raj-akhil-1/Exoskeleton/README.md

# Exoskeleton

please refer https://github.com/raj-akhil-1/Exoskeleton/blob/main/researchpapers/Exoskeleton%20Final%20Report.pdf
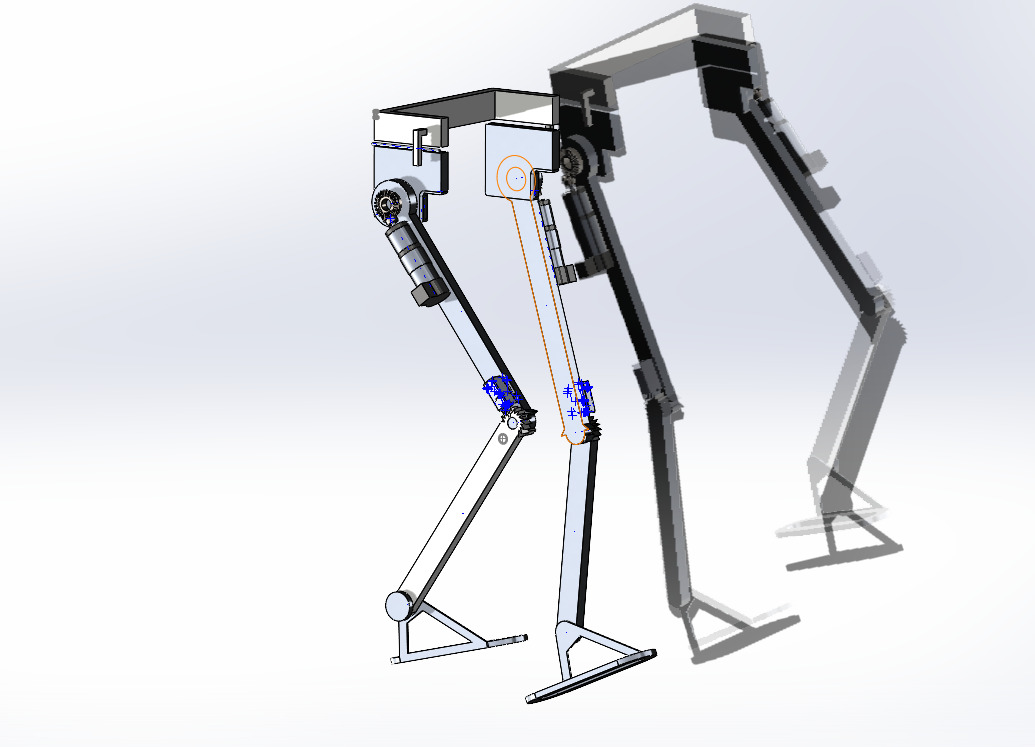
[picture p1: Results/model.png]
