raj-akhil-1/Exoskeleton/analysisresults/Screenshot (6).png

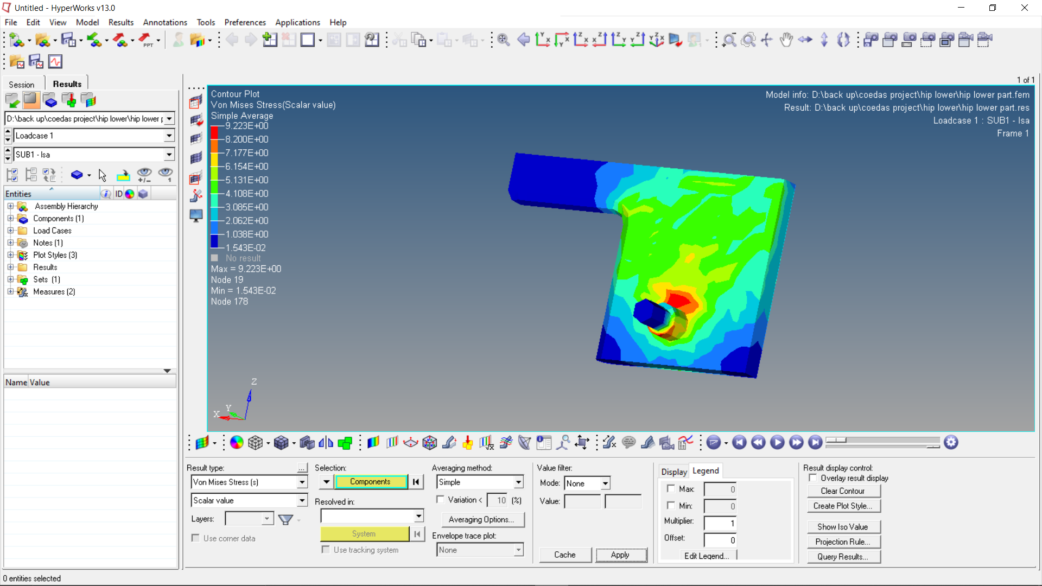
analysisresults/Screenshot (6).png
