raj-akhil-1/Exoskeleton/analysisresults/Screenshot (12).png

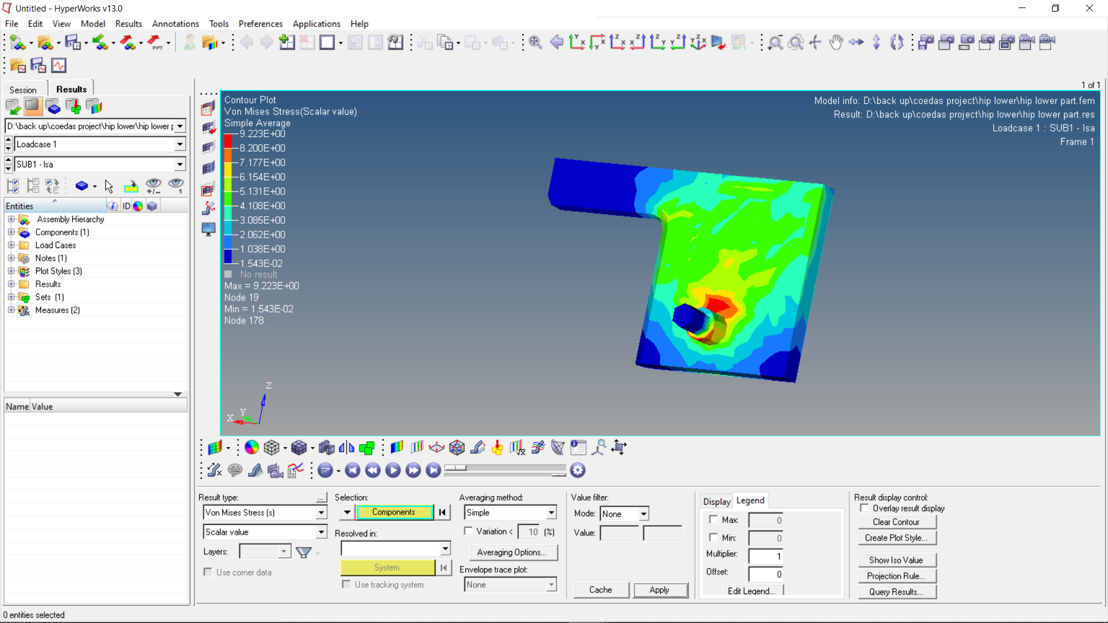
analysisresults/Screenshot (12).png
