raj-akhil-1/Exoskeleton/analysisresults/Screenshot (13).png

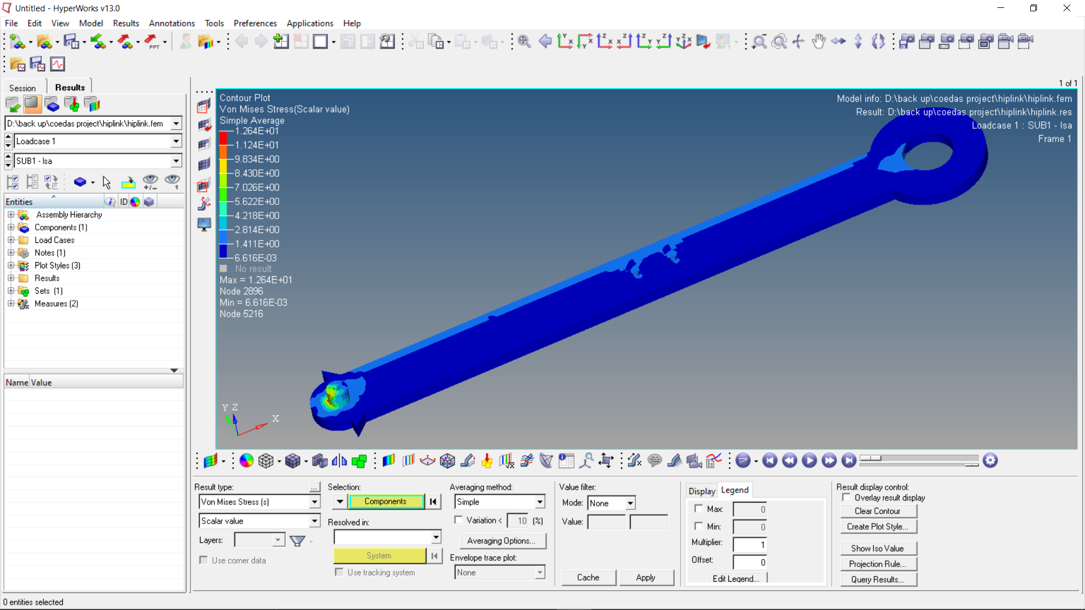
analysisresults/Screenshot (13).png
