raj-akhil-1/Exoskeleton/analysisresults/Screenshot (14).png

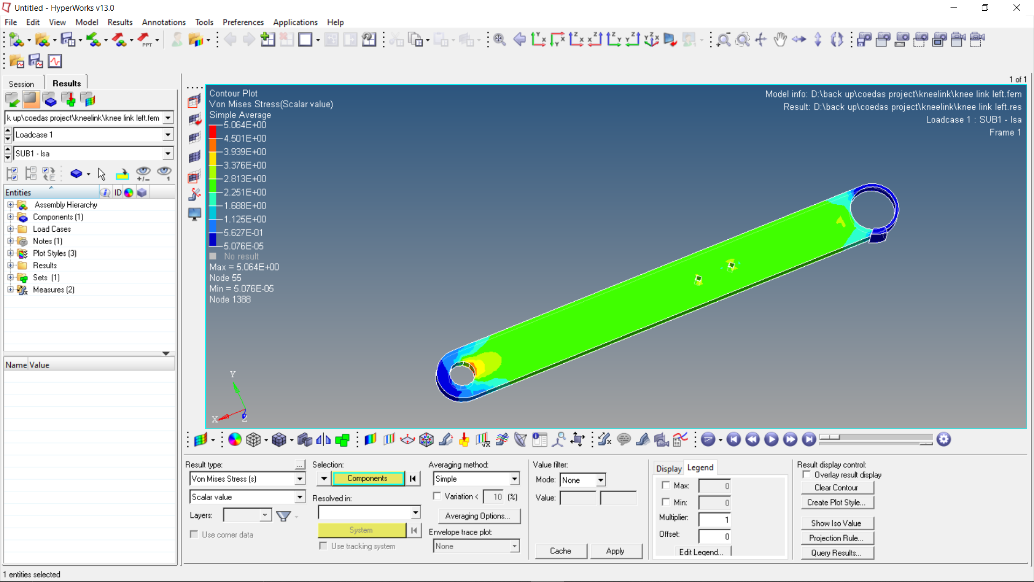
analysisresults/Screenshot (14).png
