raj-akhil-1/Exoskeleton/analysisresults/Screenshot (31).png

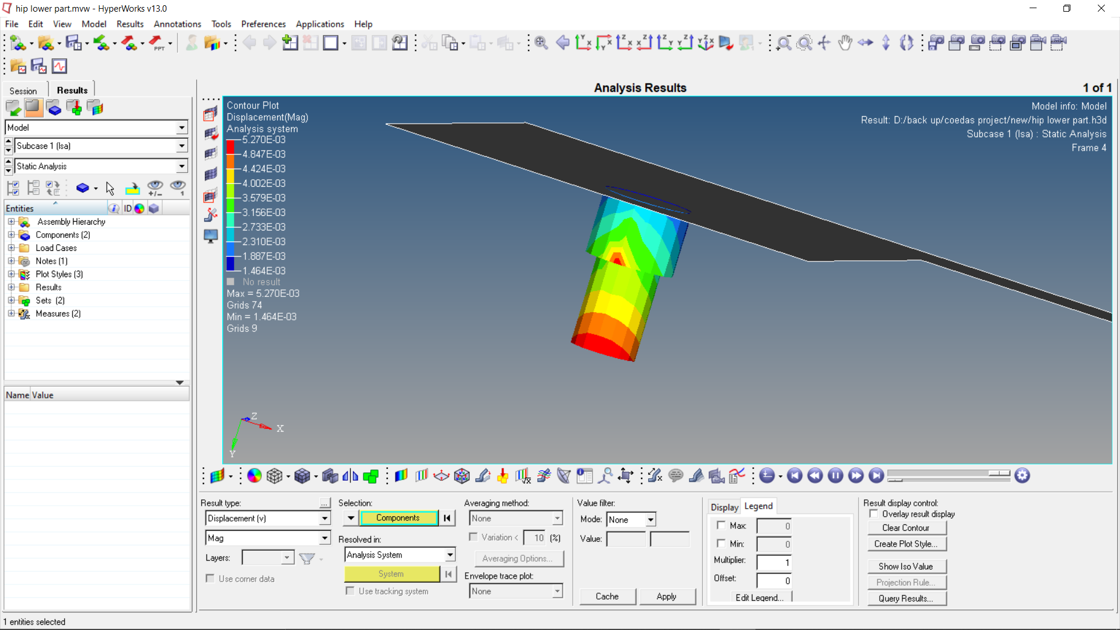
analysisresults/Screenshot (31).png
