raj-akhil-1/Exoskeleton/analysisresults/Screenshot (32).png

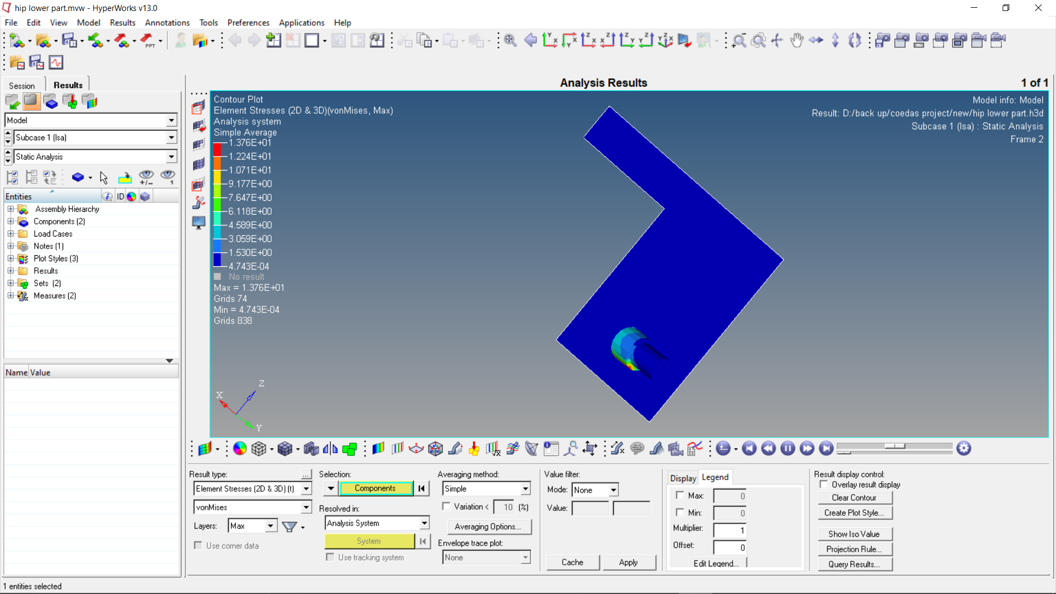
analysisresults/Screenshot (32).png
