raj-akhil-1/Exoskeleton/analysisresults/Screenshot (33).png

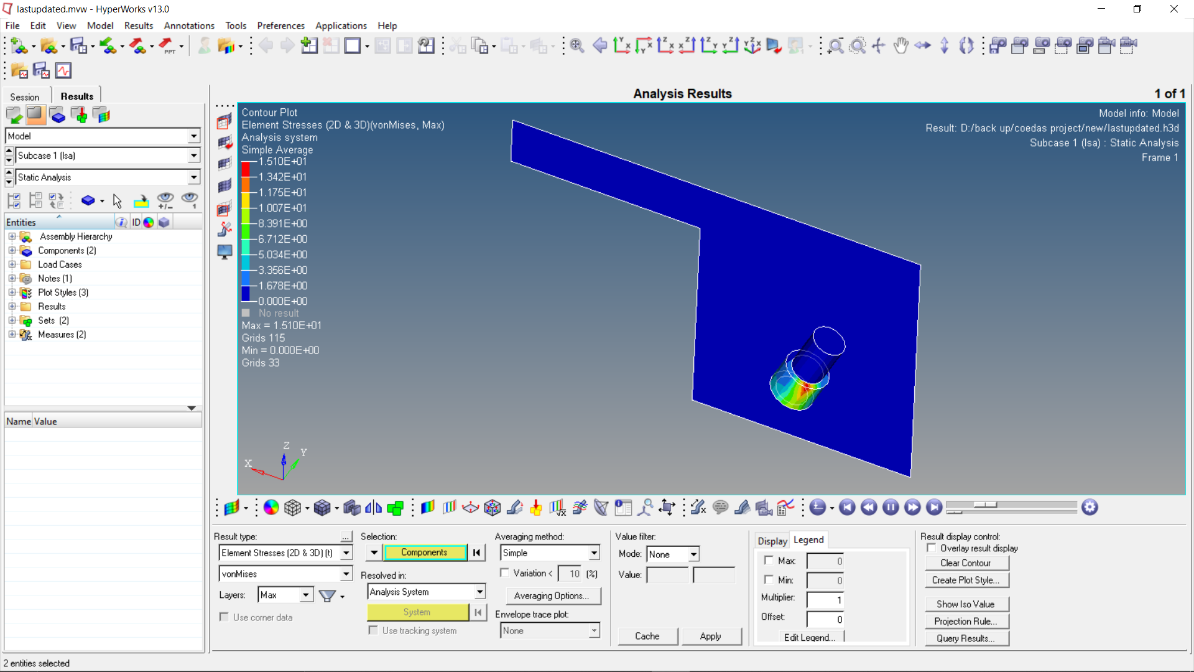
analysisresults/Screenshot (33).png
