raj-akhil-1/Exoskeleton/analysisresults/Screenshot (34).png

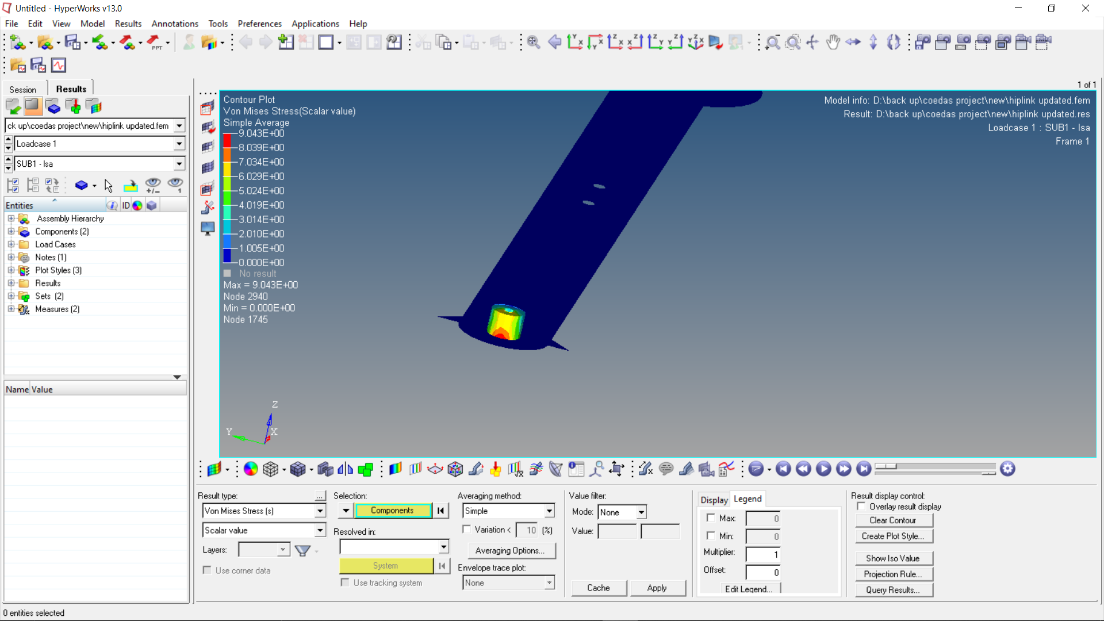
analysisresults/Screenshot (34).png
