raj-akhil-1/Exoskeleton/analysisresults/Screenshot (39).png

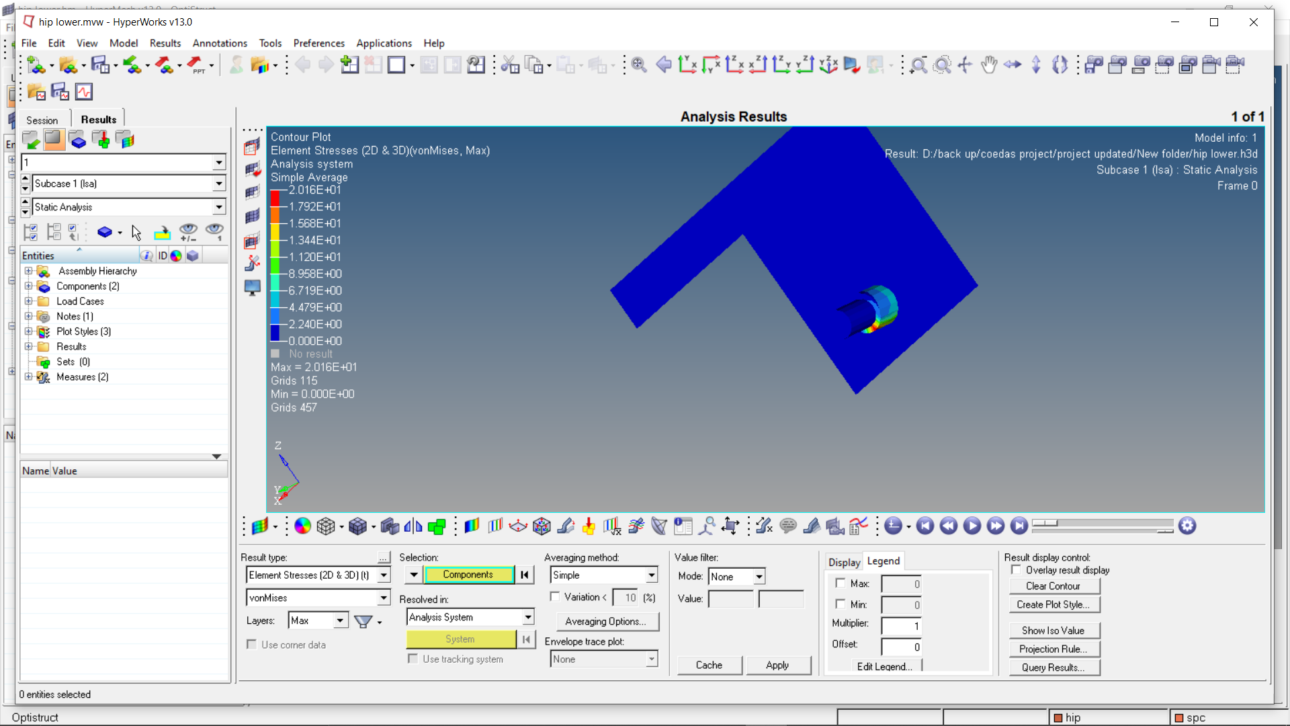
analysisresults/Screenshot (39).png
