raj-akhil-1/Exoskeleton/model/vcgcb.SLDASM

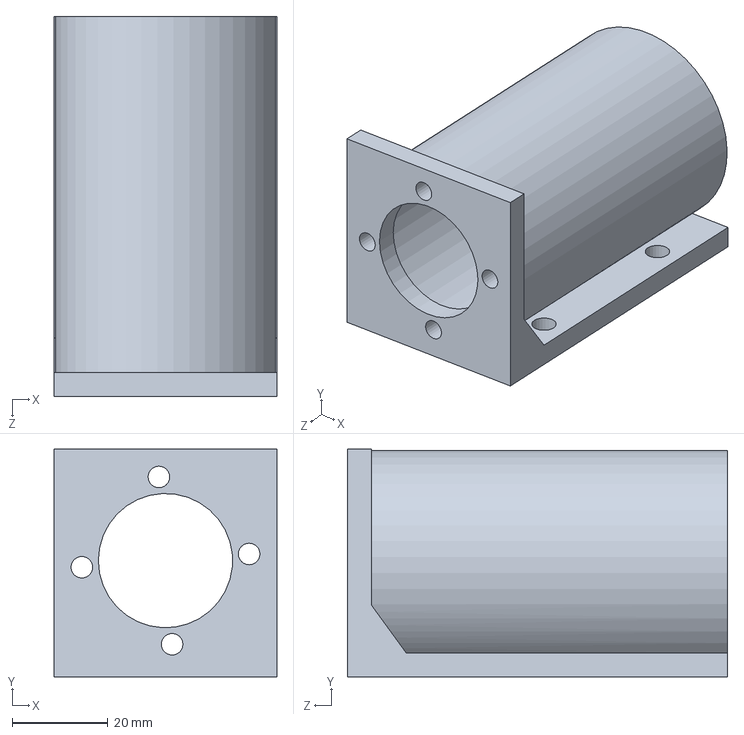
[picture p77: CAD file, 2023-05-04]
model/vcgcb.SLDASM
46.5 x 47.5 x 79.3 mm
