raj-akhil-1/Exoskeleton/model/knee lock.SLDASM

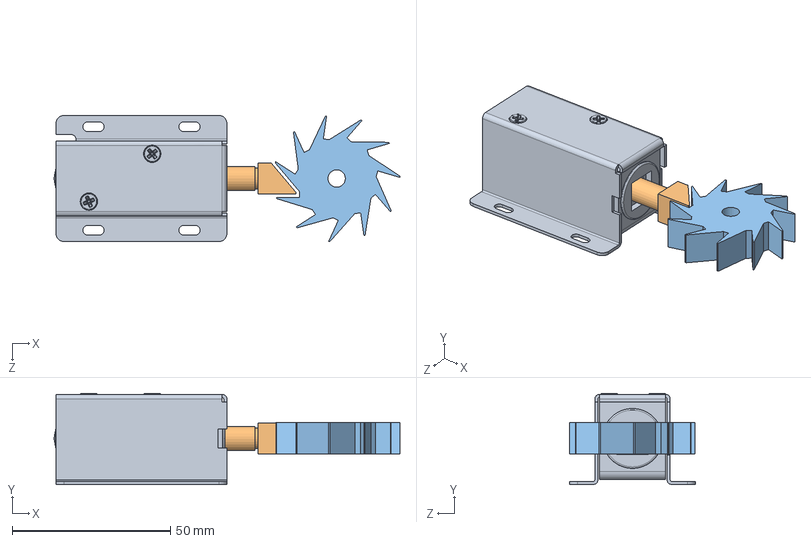
[picture p78: CAD file, 2023-05-04]
model/knee lock.SLDASM
109.3 x 28.8 x 39.8 mm
lock
lockrod
Part2^Assem1
