raj-akhil-1/Exoskeleton/model/project 1.SLDASM

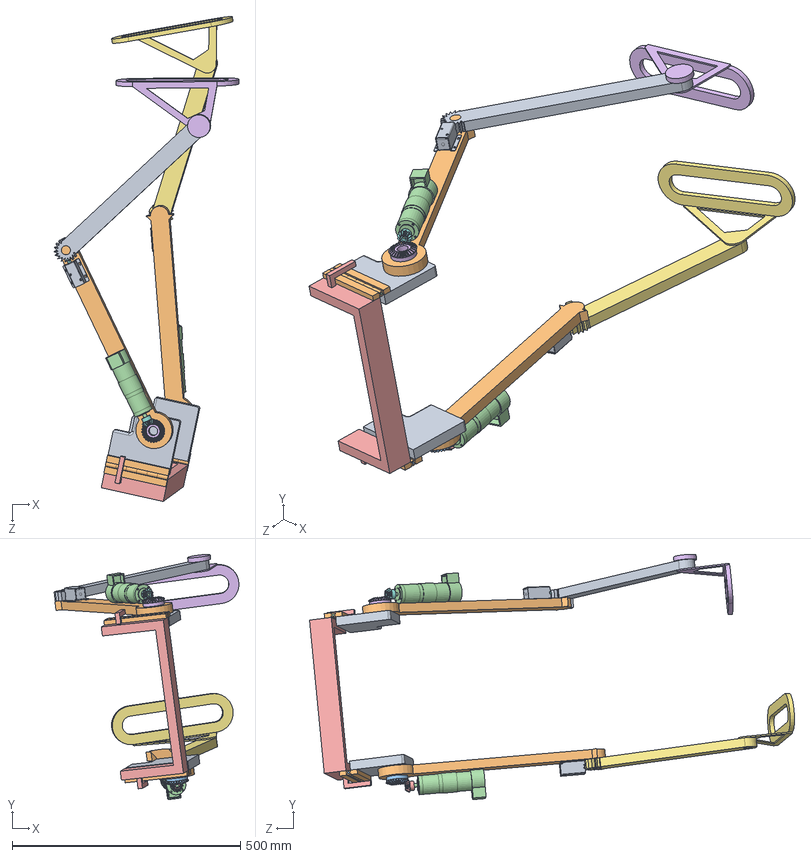
[picture p79: CAD file, 2023-05-04]
model/project 1.SLDASM
405.1 x 537.4 x 1062.1 mm
hip lower part
hip link x 2
straight bevel ghj
MOTOR1 x 2
straight bevel pinion_amwdqd
straight bevel gear_am
knee link left
straight bevel pinion_am
knee link right
ha1 x 4
hingrod
hip upper part
foot right
foot left
lockrod x 2
lock x 2
