raj-akhil-1/Exoskeleton/model/hinge assembly.SLDASM

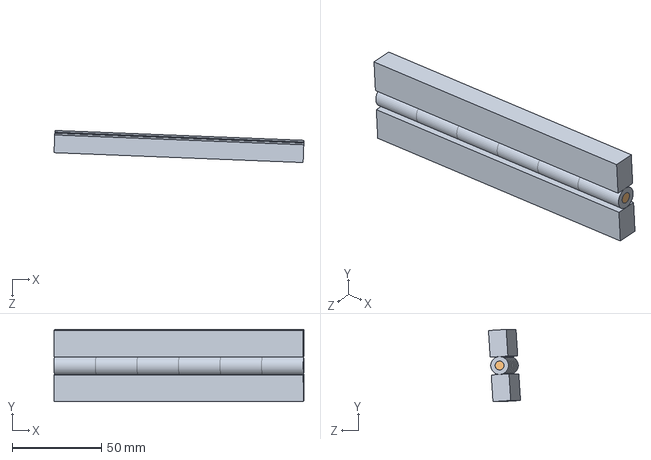
[picture p80: CAD file, 2023-05-04]
model/hinge assembly.SLDASM
140.4 x 40.6 x 18.0 mm
ha1 x 2
