raj-akhil-1/Exoskeleton/model/exo key holder.SLDPRT

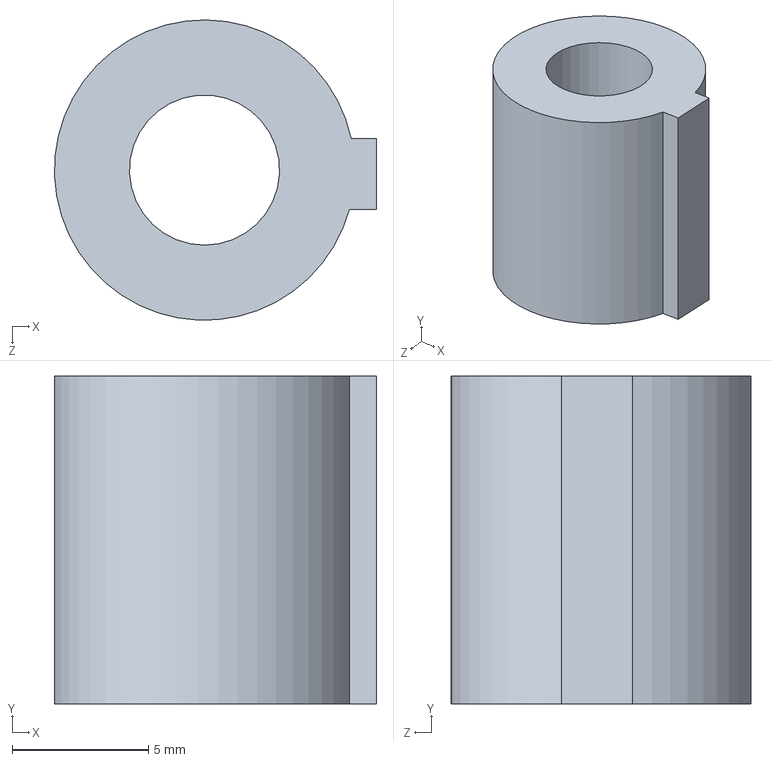
[picture p81: CAD file, 2023-05-04]
model/exo key holder.SLDPRT
11.8 x 12.0 x 11.0 mm
