raj-akhil-1/Exoskeleton/model/bevelgear.SLDPRT

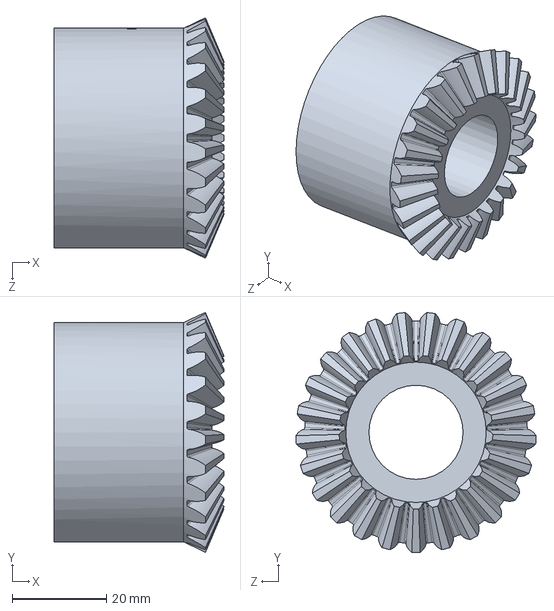
[picture p82: CAD file, 2023-05-04]
model/bevelgear.SLDPRT
36.1 x 51.0 x 51.1 mm
