raj-akhil-1/Exoskeleton/model/k_relay_holder.SLDPRT

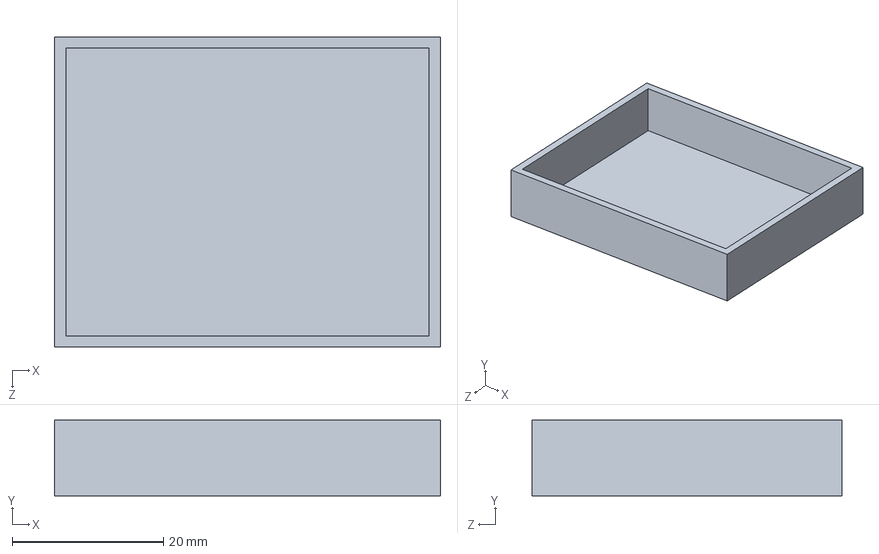
[picture p83: CAD file, 2023-05-04]
model/k_relay_holder.SLDPRT
51.0 x 10.0 x 41.0 mm
