raj-akhil-1/Exoskeleton/model/Voltage_regulator.SLDPRT

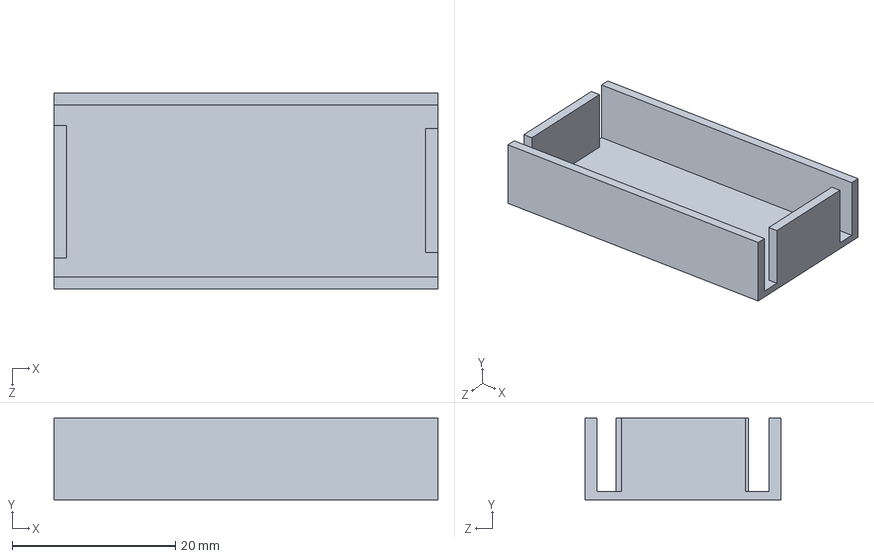
[picture p84: CAD file, 2023-05-04]
model/Voltage_regulator.SLDPRT
47.0 x 10.0 x 24.0 mm
