raj-akhil-1/Exoskeleton/model/knee link left.SLDPRT

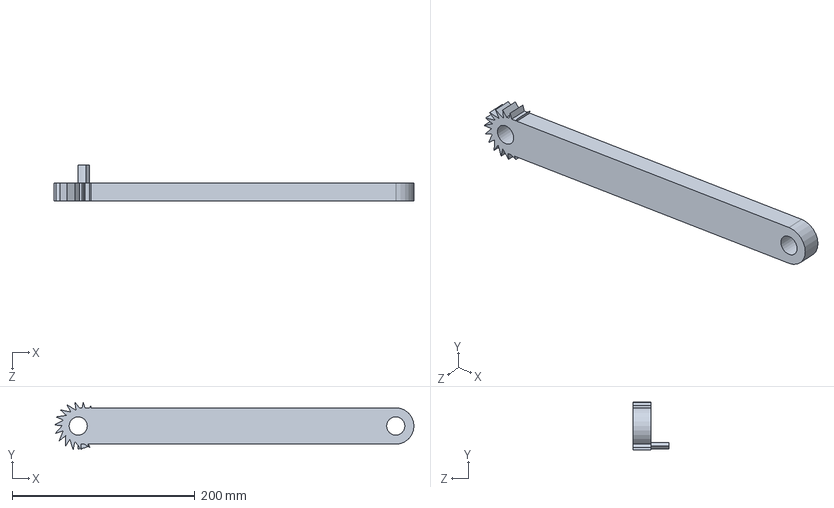
[picture p85: CAD file, 2023-05-04]
model/knee link left.SLDPRT
394.5 x 52.6 x 40.0 mm
