raj-akhil-1/Exoskeleton/model/ardunio_holder.SLDPRT

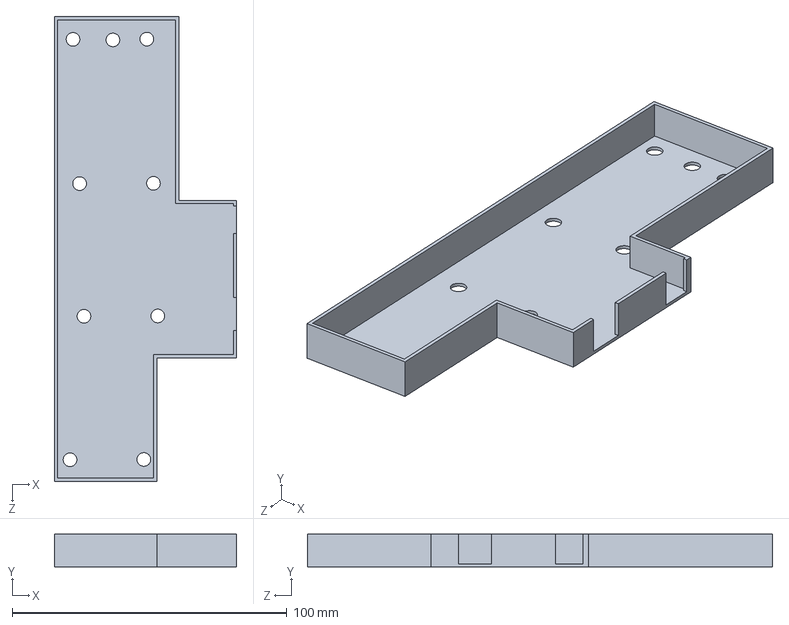
[picture p86: CAD file, 2023-05-04]
model/ardunio_holder.SLDPRT
66.4 x 12.0 x 169.4 mm
