raj-akhil-1/Exoskeleton/model/knee link right.SLDPRT

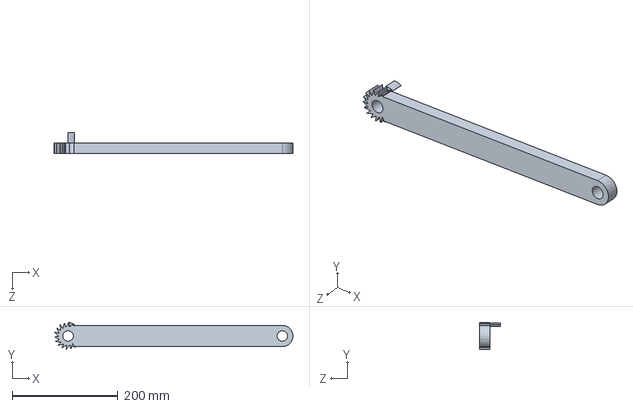
[picture p87: CAD file, 2023-05-04]
model/knee link right.SLDPRT
451.6 x 51.7 x 40.0 mm
