raj-akhil-1/Exoskeleton/model/lock.SLDPRT

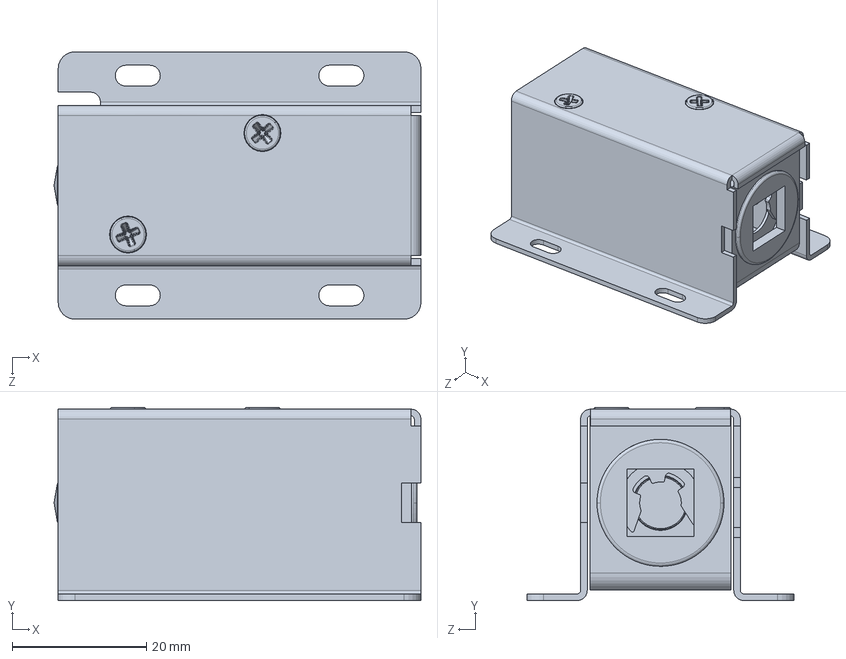
[picture p88: CAD file, 2023-05-04]
model/lock.SLDPRT
54.6 x 28.8 x 39.8 mm
