raj-akhil-1/Exoskeleton/model/hip upper part.SLDPRT

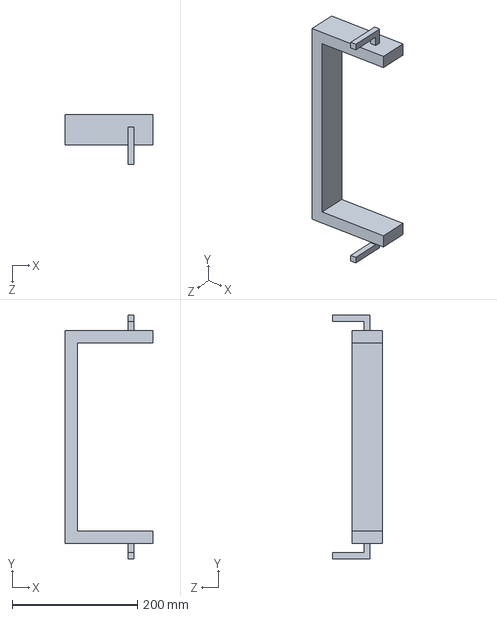
[picture p89: CAD file, 2023-05-04]
model/hip upper part.SLDPRT
140.0 x 390.0 x 80.0 mm
