raj-akhil-1/Exoskeleton/model/hip link .SLDPRT

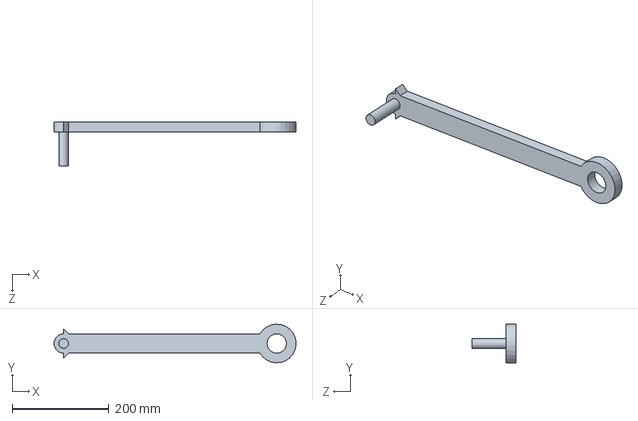
[picture p90: CAD file, 2023-05-04]
model/hip link .SLDPRT
499.7 x 79.9 x 90.0 mm
