raj-akhil-1/Exoskeleton/model/foot left.SLDPRT

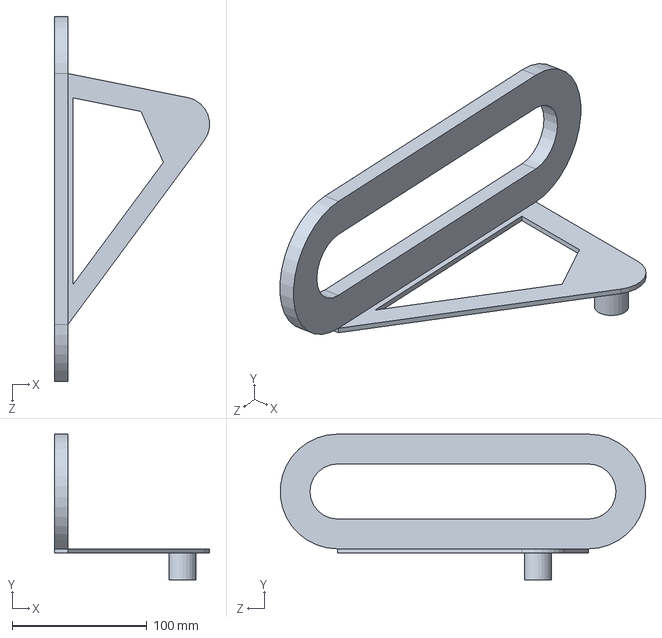
[picture p91: CAD file, 2023-05-04]
model/foot left.SLDPRT
114.9 x 108.0 x 270.6 mm
