raj-akhil-1/Exoskeleton/model/PART1.SLDPRT

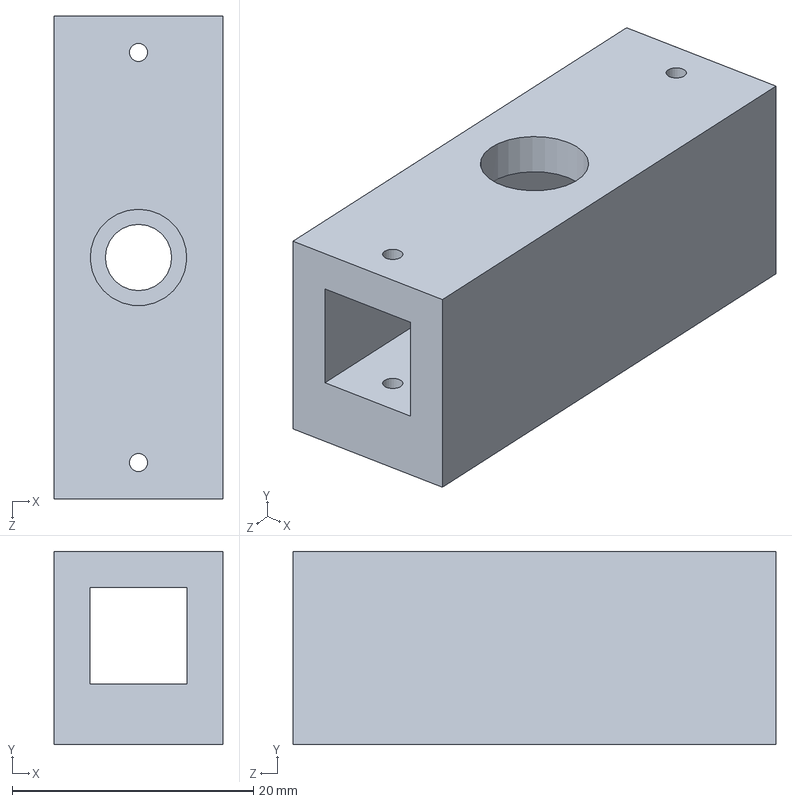
[picture p92: CAD file, 2023-05-04]
model/PART1.SLDPRT
14.0 x 16.0 x 40.0 mm
