raj-akhil-1/Exoskeleton/model/hip lower part.SLDPRT

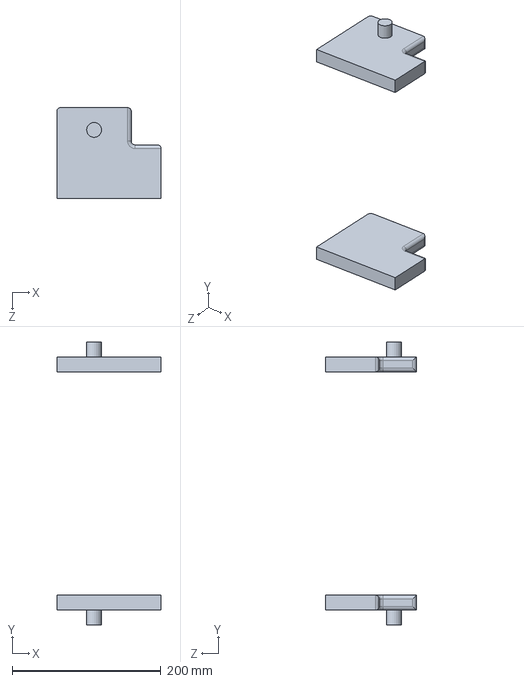
[picture p93: CAD file, 2023-05-04]
model/hip lower part.SLDPRT
140.0 x 380.0 x 122.0 mm
