raj-akhil-1/Exoskeleton/model/foot_holder.SLDPRT

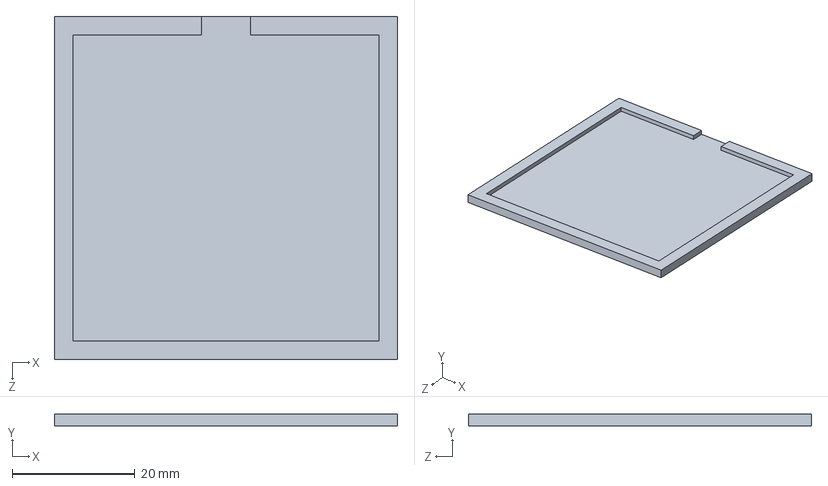
[picture p94: CAD file, 2023-05-04]
model/foot_holder.SLDPRT
56.0 x 2.00 x 56.0 mm
