raj-akhil-1/Exoskeleton/model/lockrod.SLDPRT

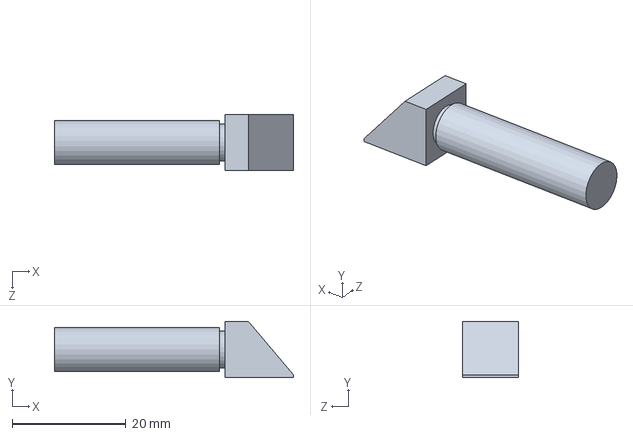
[picture p95: CAD file, 2023-05-04]
model/lockrod.SLDPRT
42.0 x 9.90 x 9.90 mm
