raj-akhil-1/Exoskeleton/model/fuse_holder.SLDPRT

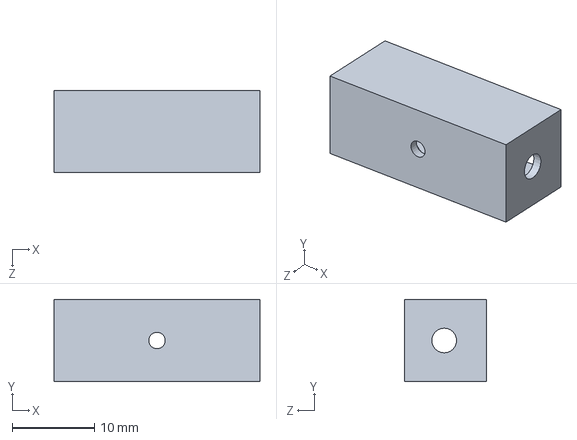
[picture p96: CAD file, 2023-05-04]
model/fuse_holder.SLDPRT
25.0 x 10.0 x 10.0 mm
