raj-akhil-1/Exoskeleton/model/knee23232.SLDPRT

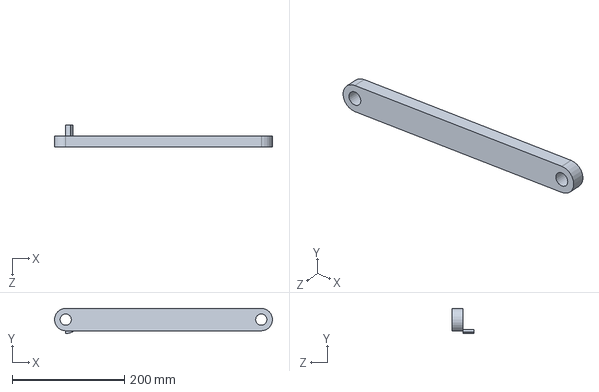
[picture p97: CAD file, 2023-05-04]
model/knee23232.SLDPRT
388.0 x 45.0 x 40.0 mm
