raj-akhil-1/Exoskeleton/model/MOTOR1.SLDPRT

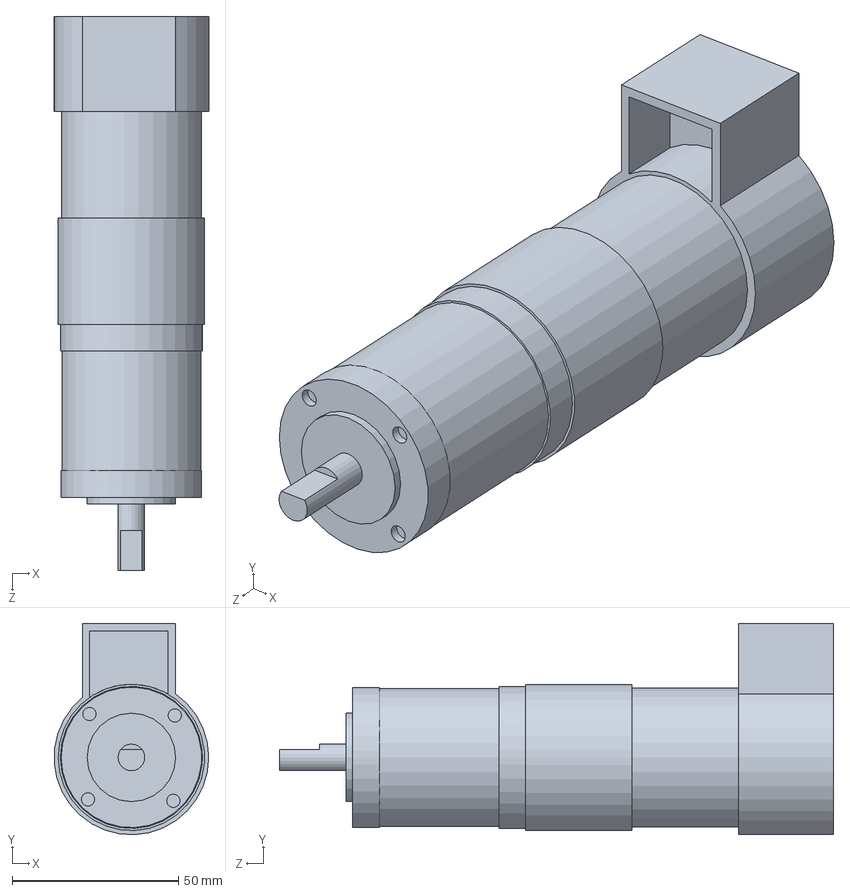
[picture p98: CAD file, 2023-05-04]
model/MOTOR1.SLDPRT
46.4 x 63.5 x 166.5 mm
