raj-akhil-1/Exoskeleton/model/Part2.SLDPRT

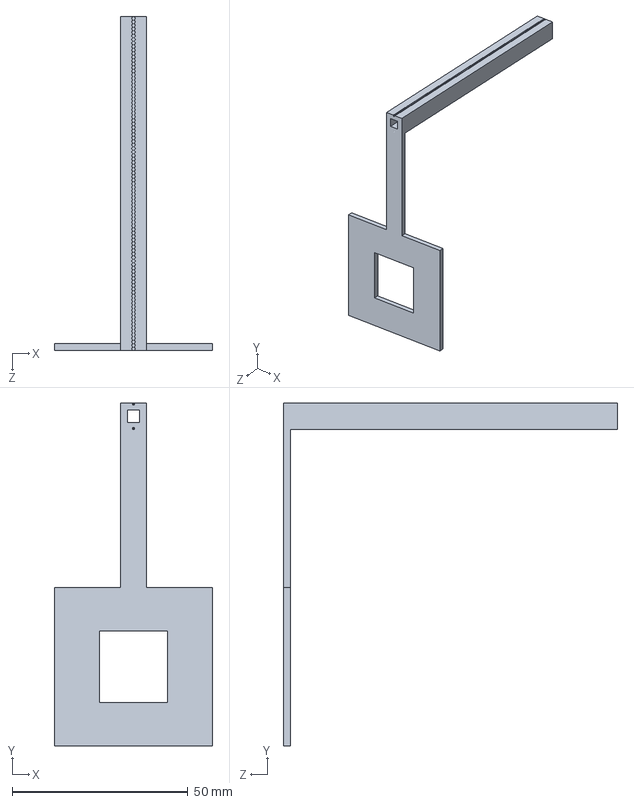
[picture p99: CAD file, 2023-05-04]
model/Part2.SLDPRT
45.0 x 97.5 x 95.0 mm
