raj-akhil-1/Exoskeleton/model/foot right.SLDPRT

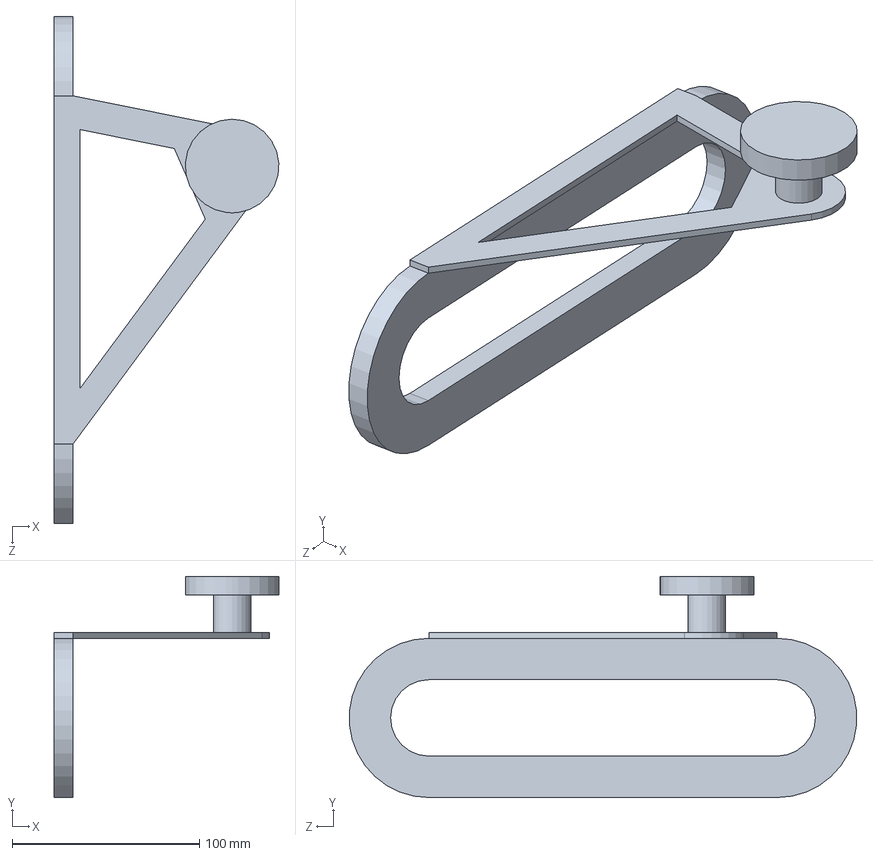
[picture p100: CAD file, 2023-05-04]
model/foot right.SLDPRT
120.0 x 118.0 x 270.6 mm
