raj-akhil-1/Exoskeleton/model/hingrod.SLDPRT

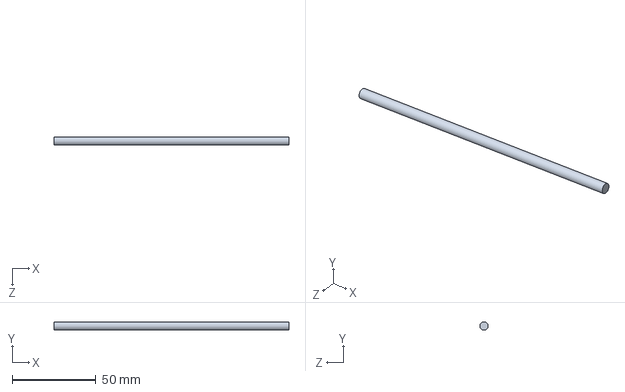
[picture p101: CAD file, 2023-05-04]
model/hingrod.SLDPRT
140.0 x 5.00 x 5.00 mm
