raj-akhil-1/Exoskeleton/model/hing.SLDPRT

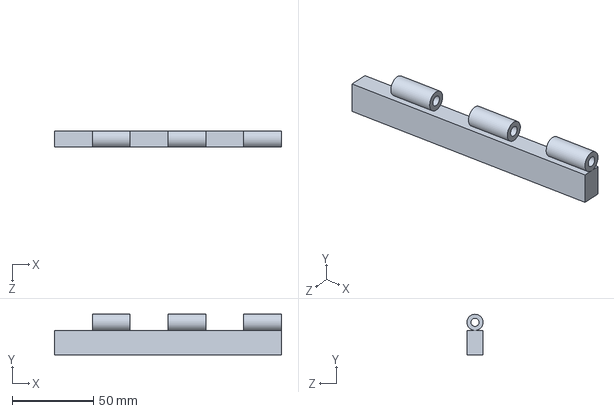
[picture p102: CAD file, 2023-05-04]
model/hing.SLDPRT
140.0 x 25.0 x 10.0 mm
