raj-akhil-1/Exoskeleton/model/Mega Torque motor.SLDPRT

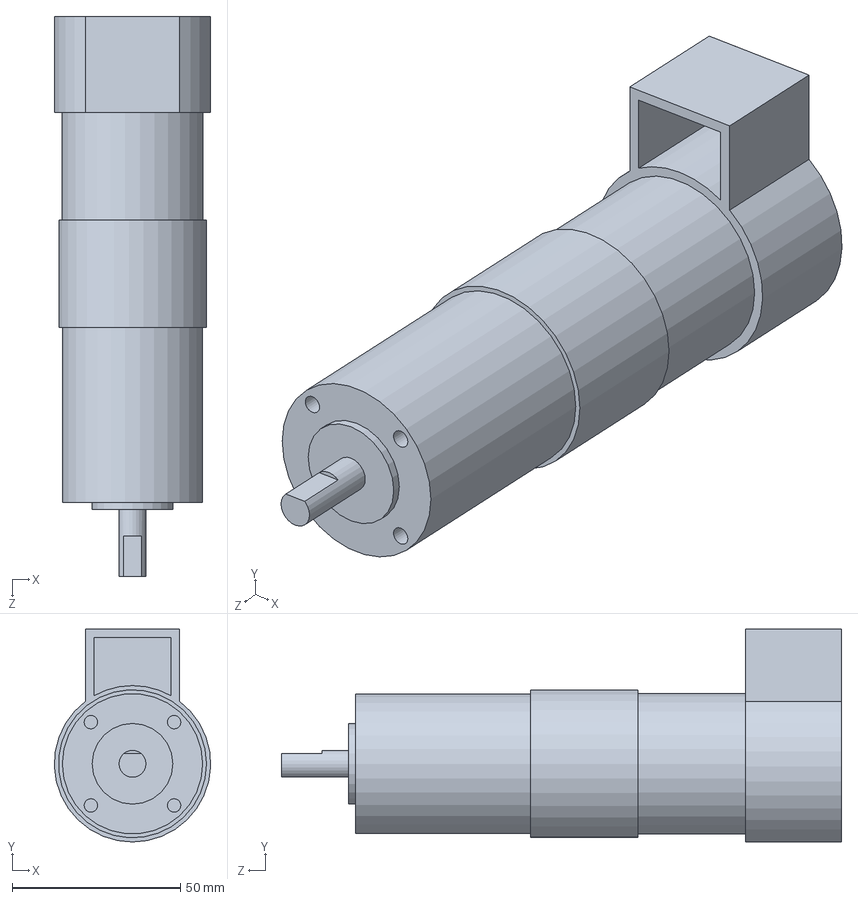
[picture p103: CAD file, 2023-05-04]
model/Mega Torque motor.SLDPRT
46.5 x 63.3 x 166.5 mm
