raj-akhil-1/Exoskeleton/(list of files, cad)

Other CAD files:
model/motor holder1.SLDPRT
model/ha.SLDPRT
model/Part1 (2).SLDPRT
model/knee lock.SLDPRT
