raj-akhil-1/Exoskeleton/Results/1st model pic.png

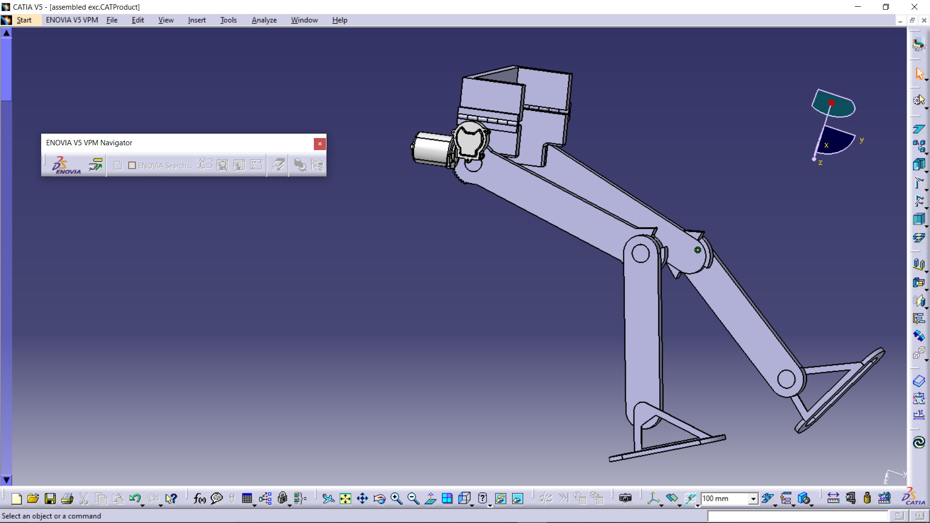
Results/1st model pic.png
