raj-akhil-1/Exoskeleton/Results/20191109_203050.jpg

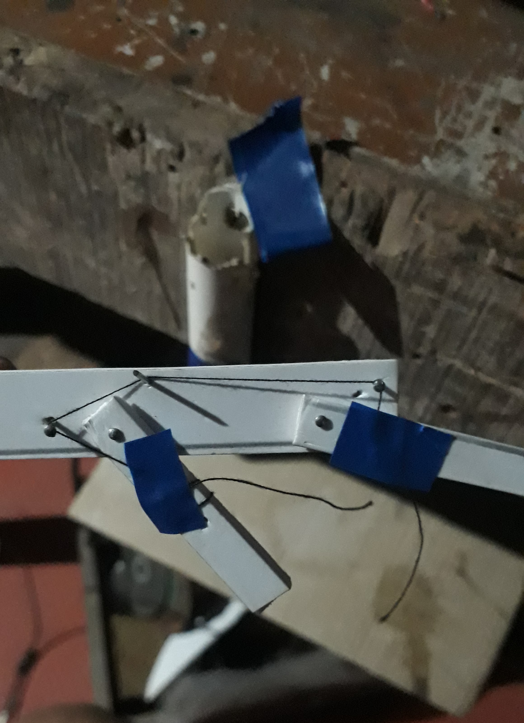
Results/20191109_203050.jpg
