raj-akhil-1/Exoskeleton/Results/20200128_213902.jpg

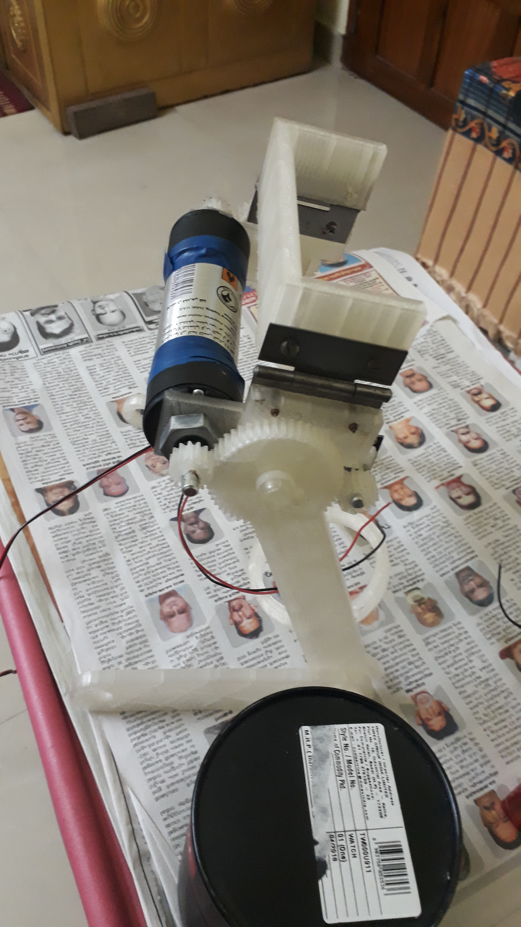
Results/20200128_213902.jpg
