raj-akhil-1/Exoskeleton/Results/20200128_213936.jpg

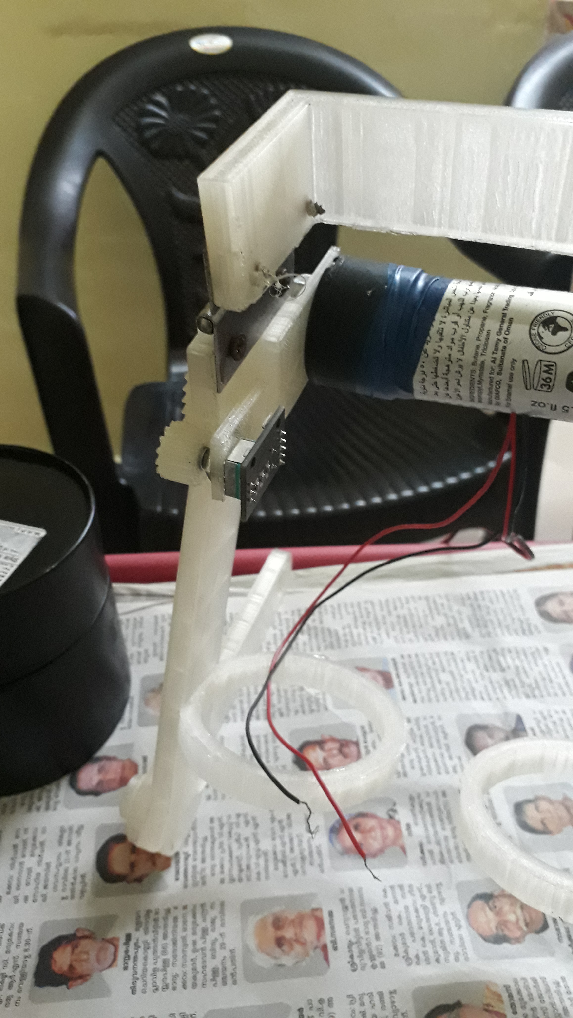
Results/20200128_213936.jpg
