raj-akhil-1/Exoskeleton/Results/20200803_143202.jpg

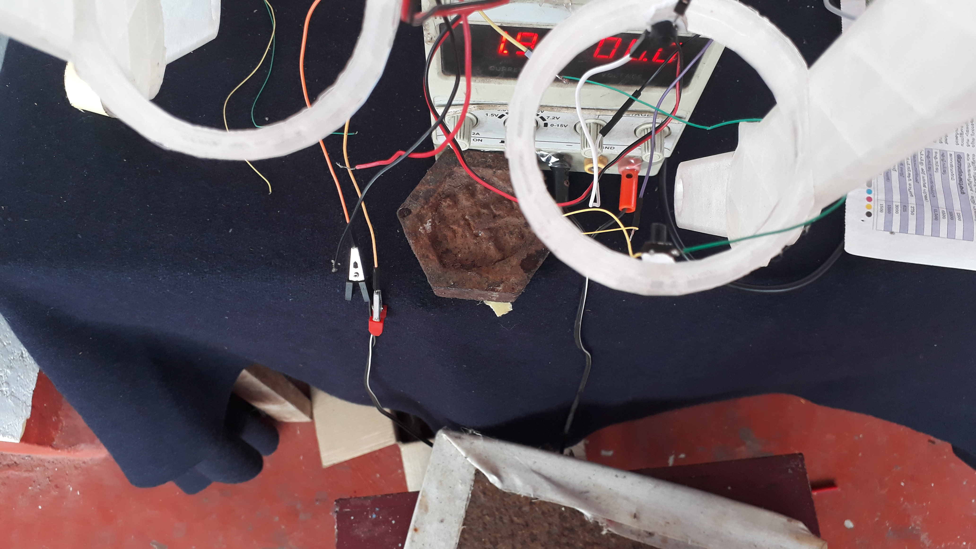
Results/20200803_143202.jpg
