raj-akhil-1/Exoskeleton/Results/20200803_143217.jpg

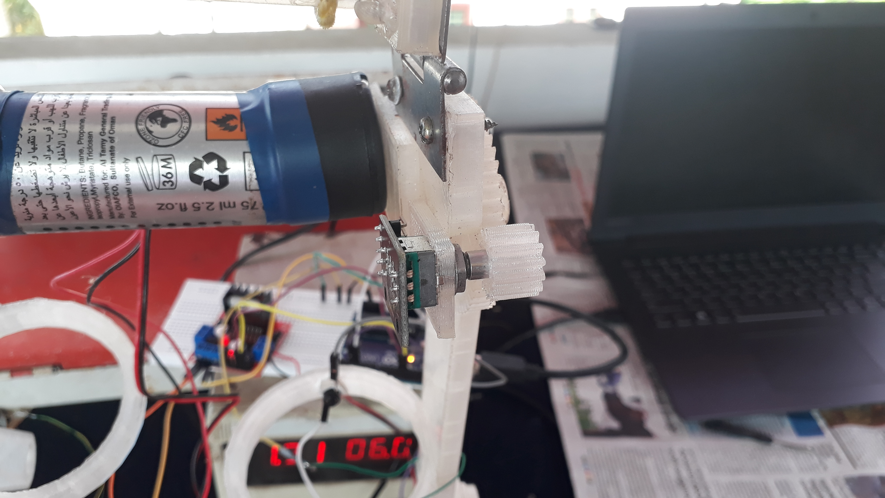
Results/20200803_143217.jpg
