raj-akhil-1/Exoskeleton/Results/20201031_222617.jpg

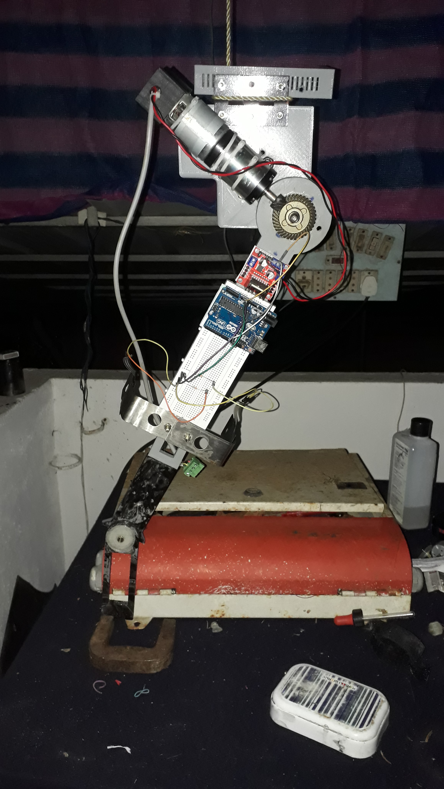
Results/20201031_222617.jpg
