raj-akhil-1/Exoskeleton/Results/20201121_172841.jpg

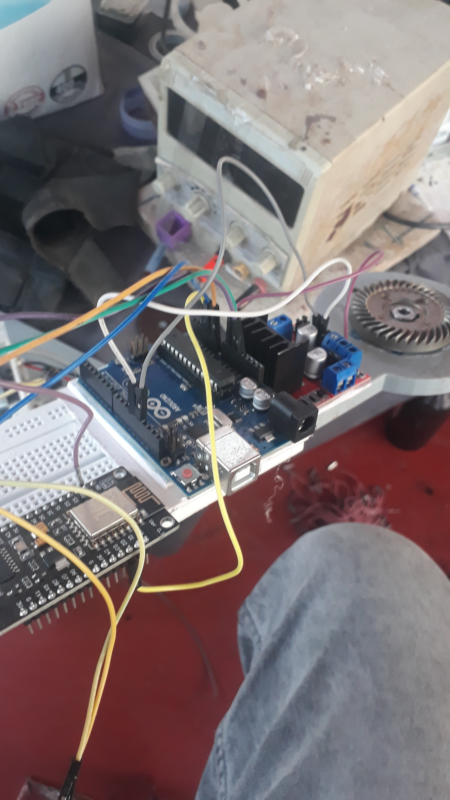
Results/20201121_172841.jpg
