raj-akhil-1/Exoskeleton/Results/20201121_172903.jpg

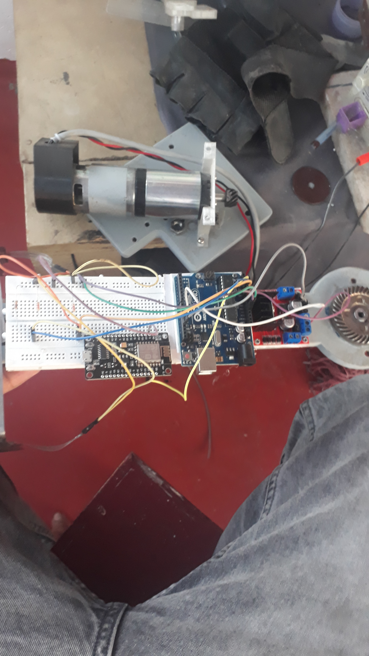
Results/20201121_172903.jpg
