raj-akhil-1/Exoskeleton/Results/not so important.jpg

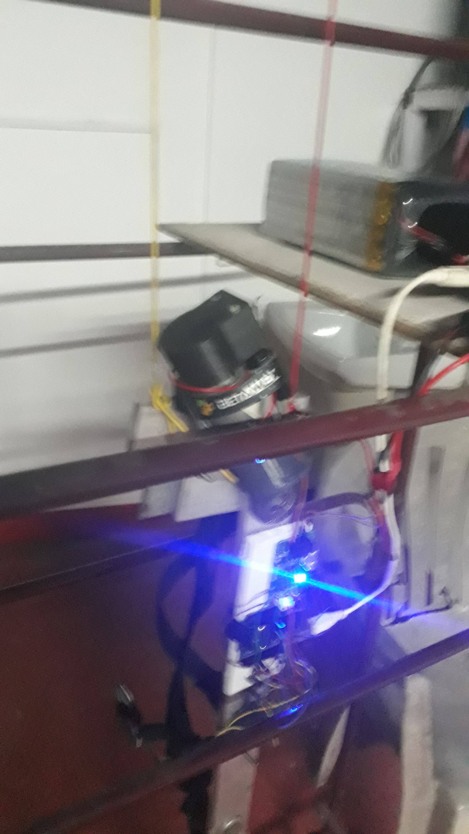
Results/not so important.jpg
