raj-akhil-1/Exoskeleton/Results/Screenshot 2023-05-01 201846.png

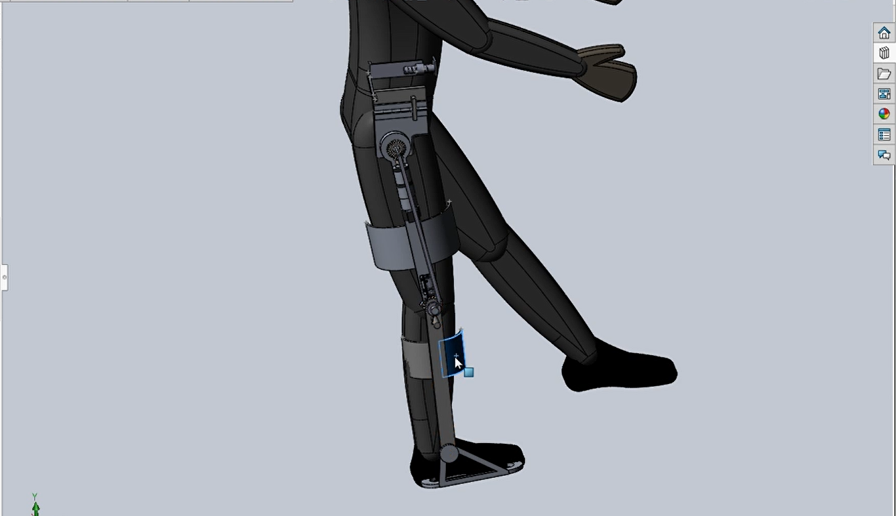
Results/Screenshot 2023-05-01 201846.png
